peterbalch/Magnetometer/IMG_2829a.JPG

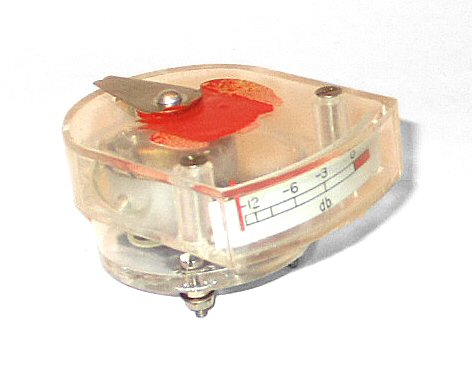
IMG_2829a.JPG
