peterbalch/Magnetometer/IMG_2832a.JPG

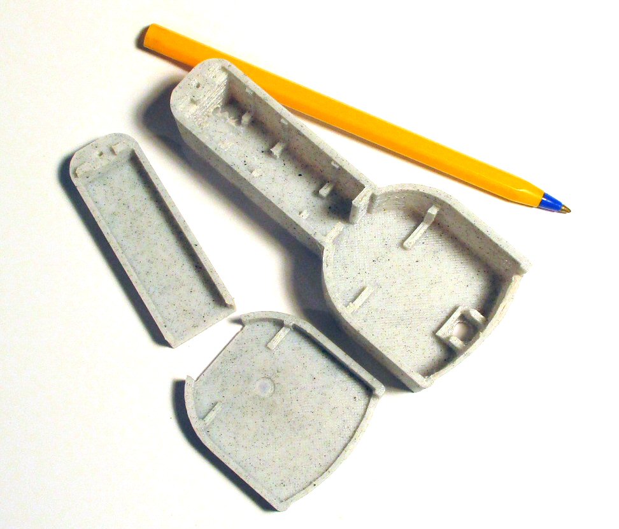
IMG_2832a.JPG
