peterbalch/Magnetometer/README.md

# Magnetometer
a very simple magnetometer

The project is documented on Instructables:
https://www.instructables.com/Simple-Gauss-Meter-Magnetometer/
