peterbalch/Magnetometer/Image9.png

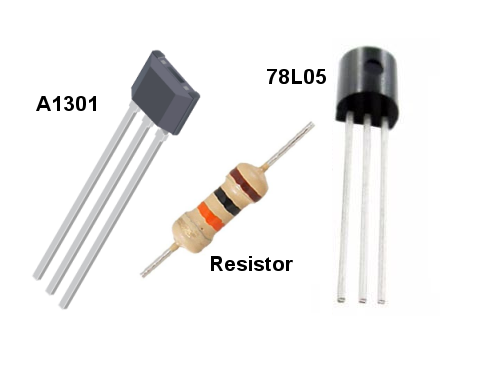
Image9.png
