peterbalch/Magnetometer/Image10a.png

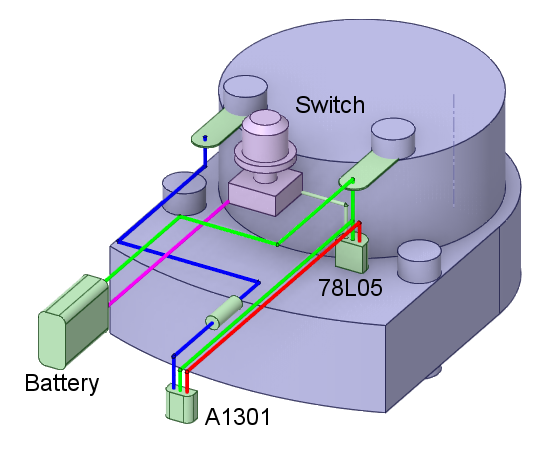
Image10a.png
