peterbalch/Magnetometer/Image11.png

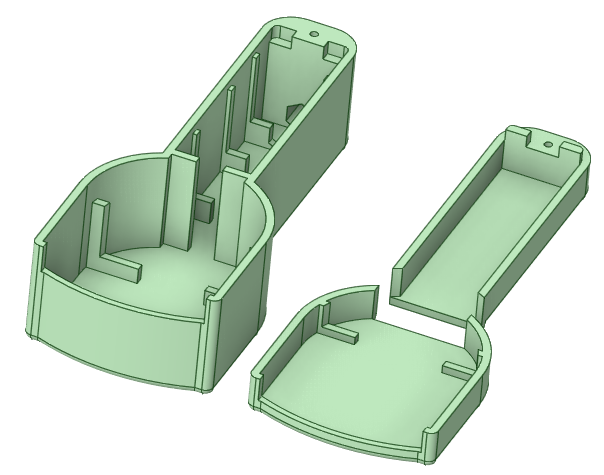
Image11.png
