peterbalch/Magnetometer/IMG_2815a.JPG

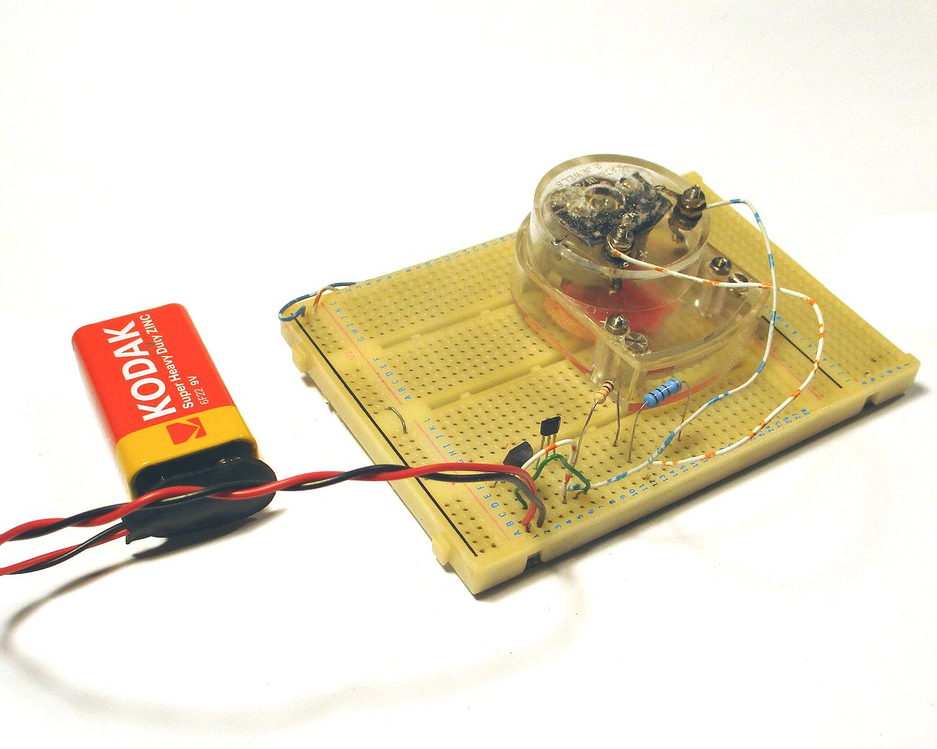
IMG_2815a.JPG
