peterbalch/Magnetometer/IMG_2852c.jpg

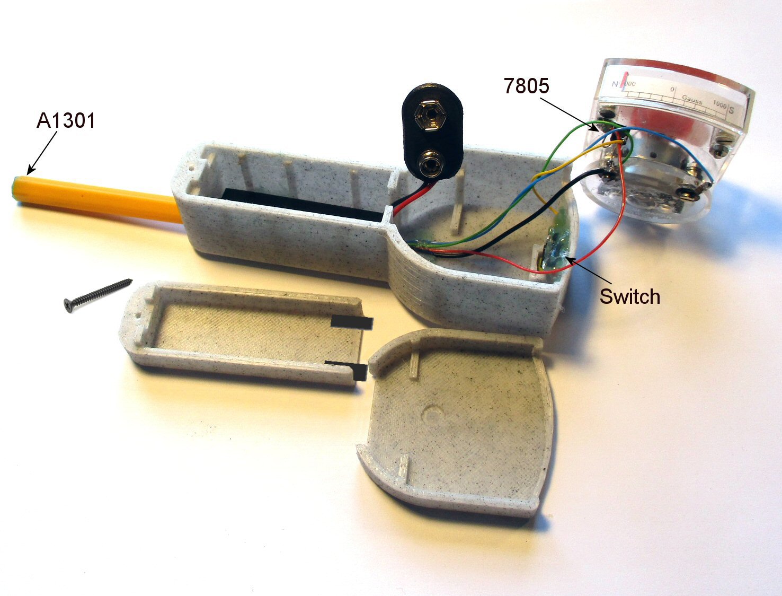
IMG_2852c.jpg
