peterbalch/Magnetometer/IMG_2868b.jpg

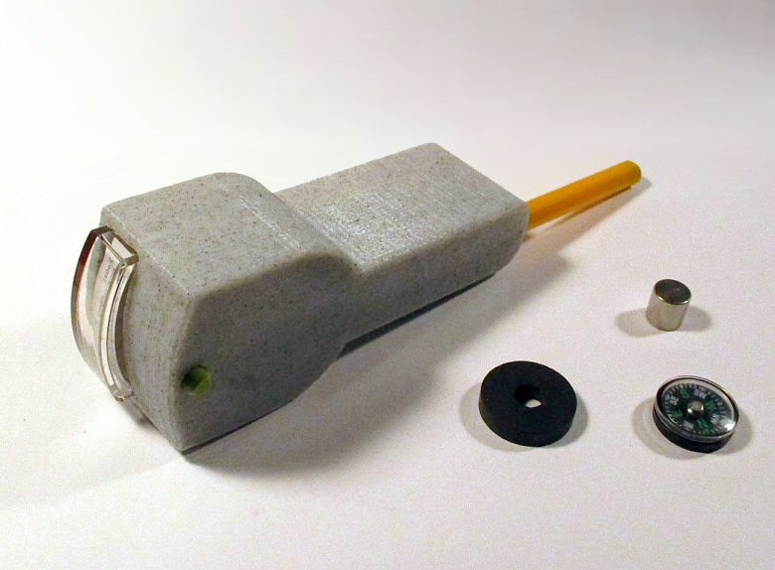
IMG_2868b.jpg
