peterbalch/Magnetometer/sch.PNG

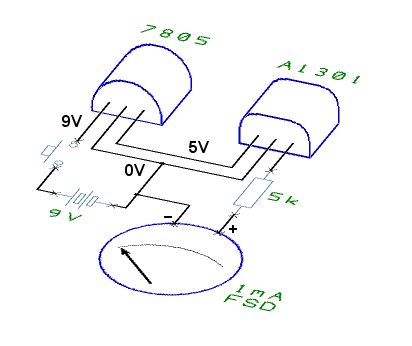
sch.PNG
