peterbalch/Magnetometer/CuraTemp_870548.stl

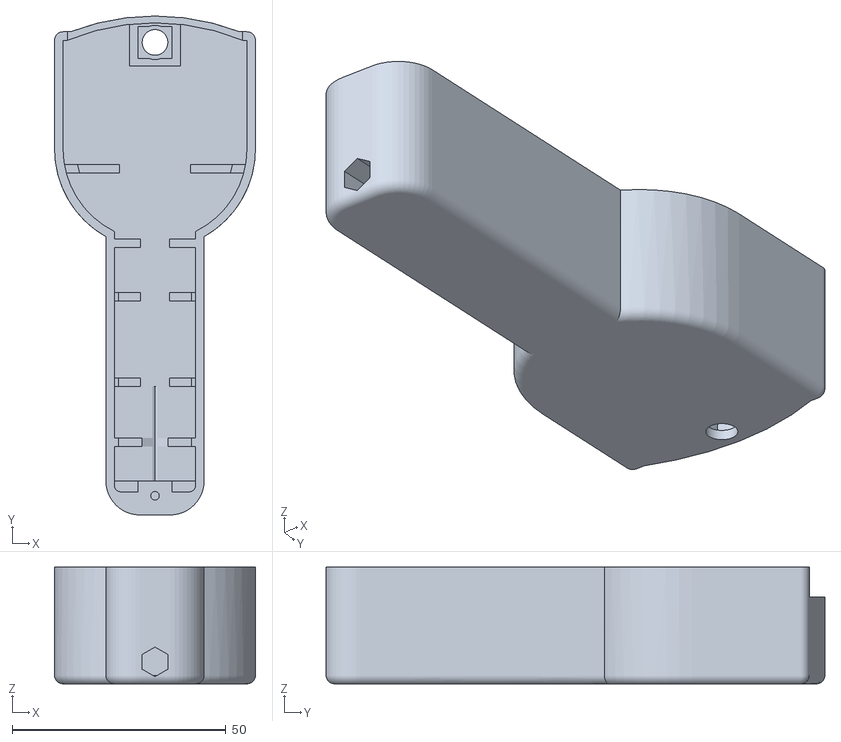
[picture p10: CAD file, 2023-12-22]
CuraTemp_870548.stl
47.0 x 116.7 x 27.3
