peterbalch/Magnetometer/CuraTemp_363488.stl

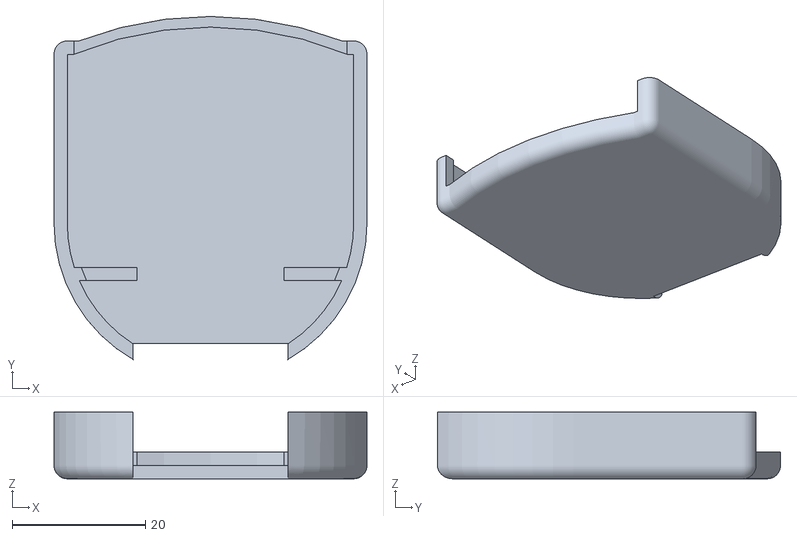
[picture p11: CAD file, 2023-12-22]
CuraTemp_363488.stl
47.0 x 51.5 x 10.00
