peterbalch/Magnetometer/CuraTemp_985060.stl

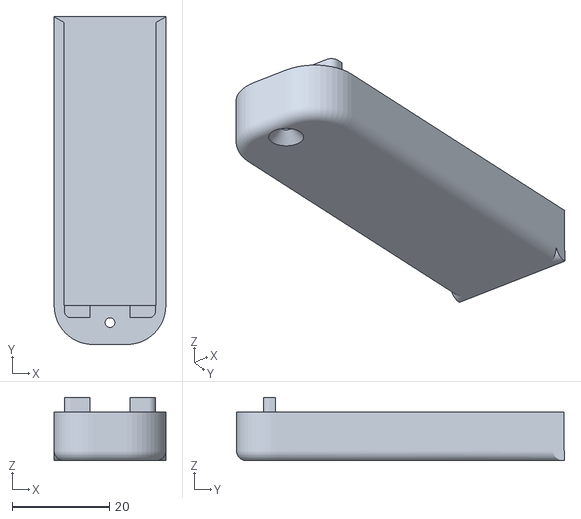
[picture p12: CAD file, 2023-12-22]
CuraTemp_985060.stl
23.0 x 67.5 x 13.0
